elhep/SPEC_A7/PCB/SPEC-A7.PcbDoc.htm

Reporting Options

# File in Newer Format

Date | : | 25.06.2024
Time | : | 12:54:33
Filename | : | C:\temp\SPEC_A7-main\SPAC_A7\SPEC-A7.PcbDoc

Version | Warning
Release 23.6 | CAUTION - The PCB document contains Footprint parameters. These will be lost when opening the document in a version of Altium Designer that does not support this functionality.
Release 23.6 | CAUTION - The saved document contains custom masks for pads. These will be lost when opening the document in a version of Altium Designer that does not support this functionality

This file was generated by a later version of the software
