elhep/SPEC_A7/(list of files, drawings)

Other design files:
PCB/10M_PPS_OUT.SchDoc
PCB/Clocks_PLL.SchDoc
PCB/DIFF_DELAY_FANOUT.SchDoc
PCB/Ext_connectors.SchDoc
PCB/FPGA_14_15.SchDoc
PCB/FPGA_34.SchDoc
PCB/FPGA_MGT.SchDoc
PCB/FPGA_PWR_CONFIG.SchDoc
PCB/Misc.SchDoc
PCB/PCIe.SchDoc
PCB/Power.SchDoc
PCB/PPS_IN.SchDoc
PCB/SFP.SchDoc
PCB/SPEC-A7-TOP.SchDoc
PCB/SPEC_A7.PrjPcb
PCB/SPEC_A71/SamacSys.PcbLib
PCB/SPEC_A71/SPEC_A7.SCHLIB
PCB/TOD.SchDoc
PCB/USB_Serial_Quad.SchDoc
PCB/VCXO_25M_DDMTD.SchDoc
PCB/VCXO_25M_PTP.SchDoc
PCB/XO_125M.SchDoc
SPAC_A7/SPEC-A7.PcbDoc
