elhep/SPEC_A7/(threads)

Thread 1 (2024-02-20):

Low cost WR node - RFQ

gkasprow, 2024-02-20:
Initial specificacion:

Design based on Sinara EEM FMC Carrier
- FMC, memory, FPGA, stack up copied with the layout from EFC design
- Power supply copied from KASLI-DIOT
- 2 assembly variants: FMC or SMA/LEMO connectors: 2x IO, PPS OUT, 10MHZ OUT, programmable RF out
- on-board low jitter synthesizer like LMX2572 with SYNC controlled from WR core
- onboard GPS receiver or connectors for GPS signal: Rx/Tx, 10MHz IN, PPS IN
- PCIe x2
- SFP x1 or x2
- USB serial with JTAG programmer
- supplied from PCIe connector or external 12V barrel connector like in SPEC

kaolpr, 2024-02-20:
Some questions that comes to my mind:
- What are expected use-cases?
- Why go with different form-factor than Sinara/DIOT?
- How (despite the onboard GPS) this is different from SPEC7? Maybe we could just make a FMC with extra features? If CERN has step pricing for XC7Z035-1FBG676C the price tag may not be that lower after all.

gkasprow, 2024-02-20:
It's going to be ultra low cost minimalistic version of affordable WR node.
Same gateware and hw can be used for Wenzel DIOT module.

kaolpr, 2024-02-21:
So you basically want to mix https://ohwr.org/project/cute-wr-a7/wikis/home with https://ohwr.org/project/babywr/wikis/home and add GPS receiver?

I'm just curious if we could make it in a form-factor that would allow direct application in other projects (e.g. aforementioned Wenzel module) as a mezzanine or SOM?

gkasprow, 2024-02-21:
I want a single low-cost minimalistic WR node without using expensive SOCs, mezzanine connectors, and modules because they all add cost and make the total solution at least 2kEUR per piece.
I just found out the ARTIX-based WR-Cute version existed.
The idea is to make a module for stand-alone applications that can also be a reference for our Wenzel module.

gkasprow, 2024-03-07:
initial placement
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

gkasprow, 2024-06-05:
Initial routing
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

gkasprow, 2024-06-11:
Stand-alone version with management module
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

gkasprow, 2024-06-11:
Quad SPEC-A7 box
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

Thread 2 (2024-05-08):

SCH review

gkasprow, 2024-05-08:
- change designators of all ICs to IC, not U
- output of LMX2572RHA goes to SMA directly, not via TTL buffer
- all clock chips must be supplied via 3.3V LDO, make 3.6V output from DC/DC converter, pass it via LDO as in CUTE design
- use only CERN libraries
- add series termination at the OSC1 output going to LMX chip
- split PLL_CLK into dedicated clock pairs. for the moment it's hard see what signal goes where
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
- some outputs from AD9516 are LVPECL and need pulldowns + series resistors to match FPGA levels; look how it's made in WR switch design
- SFP_0.LED and SFP_1.LED goes to nowhere
- there are many errors in ERC, correct them all (but not by changing rules).
- use SPEC PCB with stackup as a template
- rename sheet FPGA34 to FPGA 34 SDRAM or add note SDRAM on schematic
- rename sheet FPGA PWR to FPGA PWR CONFIG
- use only CERN components; send me a list of missing ones
- make sure the oscillators are available. The ones used in CUTE-WR have the right PN in the part description.
- connect control lines of EXT pll in the same way as in CIRE-WR baseboard
-

gkasprow, 2024-05-18:
Add I2C 24c64 eeprom connected in the same way as on SPEC

gkasprow, 2024-05-21:
- [ ] we need SDRAM, we have free 15 pins in bank 15 so no need to sacrify the SDRAM
- [ ] we don't need all the LMX control pins, just SPI and SYNC

gkasprow, 2024-05-21:
- [ ] please add note on schematic about bank power supply value

gkasprow, 2024-05-21:
- [ ] use NP0 for C139, C150, we need them to be low noise caps
- [ ] pls use MGT0, 1 for PCIe, MGT2,3 for SFP or vice-versa, don't interleave them
- [ ] we do need PCIe clock, move 125MHz clock to bank 15 clock input and add capacitor assembly option to route CLK125 to either bank 15 or MGT bank
- [ ] add 24LC64 EEPROM connected to I2C lines
- [ ] add assembly option (2x 0R resistors) that bypasses IC22, IC20, IC23 (low cost version)

gkasprow, 2024-05-21:
- [ ] add annotation about levels of RGMII and other non 3V3 signals on ext connector

gkasprow, 2024-05-21:
- [ ] missing TOD IN, TOD OUT; make it as MMCX
- [ ] replace HSMS diodes by popular BAV** Schottky ones
- [ ] can we unify 3.3V LDOs? Use low cost ones, preferably from DIODES/Microchip/Onsemi
- [ ] V_tap is current measurement; add low cost current measurement chip
- [ ] replace oscilaltors PN
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

gkasprow, 2024-05-21:
- [ ] wrong variant may cause board damage: use no_value components
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

gkasprow, 2024-05-21:
- [ ] add separate i2C connectors for dc/dc converters, they all share same I2C address
- [ ] is JTAG 2.5V or 3.3V?
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

gkasprow, 2024-05-21:
- [ ] move RGMII to 3.3V bank to match levels of IMX93/STM32 CPU

gkasprow, 2024-05-28:
- [ ] add series termination resistors (33Ohm or so) to RGMII Tx pins (FPGA outputs)

gkasprow, 2024-06-05:
- [ ] add HyperRAM

gkasprow, 2024-06-06:
- [ ] remove T2, reduce R31 to 3k3 and supply LD2 from P5V0 directly; for the moment LD2 threshold is below 1V.
- [ ] replace LT1965EDD#PBF (IC41, IC17, IC18) with cheaper LDO like
- [ ] use CERN libraries, replace BLM18KG221SN1D with BLM18SG221TN1 everywhere
- [ ] ADR1500BKSZ is not available, replace it with LM1041 or sth cheap having 1.25V
- [ ] We don't need U1A x 4 to drive the FPGA input. Use one I1A buffer as TOD IN and 3 U1A buffers as TOD OUT, there is no need to use IC39 and 5V0 rail
- [ ] I think we could reduce the number of DC/DC converters. We don't need 5V rail, VCCBRAM could be connected with MGTAVCC. We don't need 6A at P1V0 rail as well as 6A at MGTAVCC rail. MPM54304GMN-0001 has 4 independent output channels.

gkasprow, 2024-06-06:
- [ ] please add 0805 1mOhm resistors at each DC/DC output, we will measure the currents and decide how to simplify the rails in next revision

gkasprow, 2024-06-07:
- [ ] use WUT templates for all schematic files

gkasprow, 2024-06-11:
- [ ] pls add power LED  on the front panel and one LED under each SMA connector

gkasprow, 2024-06-25:
- [ ] add OSC_CONNOR-WINFIELD_DOT050V as alternative VCXO
- [ ] add FT230XS-R as alternative low cost UART

gkasprow, 2024-06-25:
- [ ] swap R25 with R27
- [ ] swap R13 with R14

mkiepiela, 2024-07-01:
- [ ] Connect nREFIN of IC14 to GND (via capacitor).
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

- [ ] C242 and C243 should be 100 nF.
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

- [ ] IC39, IC44 and IC45 are powered by 5V0 while ICLK are driven by 3V3 level signals. Minimum input H level is higher than the signal.
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

- [ ] Output impedance of IC39, IC44 and IC45 is about 20R, so R154, R190 and R195 should be about 30R (not 47R) or even less if R155, R193 or R198 are mounted. Place a note on the scheme.
- [ ] EN pin of IC3 is driven by MGTAVTT (1V2). It's to less - EN threshold is 1.21V +/- 2.5%.
- [ ] I2C 10k pull ups (R40, R41) - should be 2k2 if 400 kHz mode is to be used.
- [ ] Lack of 100 nF caps at P1V8_USB pins of IC32.
- [ ] R113/R114 divider - change values to not exceed nRESET input level of IC32. Increase R113 due to application note:
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

- [ ] Schematic symbol of Y2 does not correspond to its PN. Pin 2 should be OE not nST.

gkasprow, 2024-07-22:
C139, C150 PN indicates 10nF

Thread 7 (2024-10-08):

move JTAG connector

gkasprow, 2024-10-08:
It collides with Eurocard rack

Thread 10 (2025-04-15):

P3V0_VCXO oscillation

polprog, 2025-04-15:
When using MIC5129 (IC47) to power the VCXO, its output rail has some heavy oscillations (400mVpp, 9kHz ). This results in bad phase noise performance on the 25MHz clock and in turn 10MHz output.

It is caused by not enough capacitance on the LDO output. A temporary fix was carried out on one of the boards by attaching 22uF 10V tantalum cap (Vishay 293D226X9010A2TE3) instead of C161 and connecting the ground with soldering braid for low Z path.

MIC5129 datasheet states that:

An output capacitor is required between OUT and GND
to prevent oscillation. The minimum size of the output
capacitor is dependent upon whether a reference
bypass capacitor is used. 1 μF minimum is
recommended when C BYP is not used (see Figure 4-5).
2.2 μF minimum is recommended when C BYP is 470 pF
(see Figure 4-6). **For applications <3V, the output
capacitor should be increased to 22 μF minimum to
reduce start-up overshoot.** Larger values improve the
regulator’s transient response. The output capacitor
value may be increased without limit.

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

gkasprow, 2025-04-15:
This is not an issue with too low capacitance but with  capacitor losses. Just replace ceramic one with tantalum one.

polprog, 2025-05-12:
The output capacitors on IC19, IC46, IC47 were replaced with 10uF 16V tantalum capacitors, this fixes the LDO oscillations.

Thread 11 (2025-05-12):

Spurs on 10MHz output

polprog, 2025-05-12:
The output buffers IC44 and IC45 are powered directly from a buck converter which leads to mixing of power supply ripple with frequency outputs. This creates a spur in phase noise at the operating frequency of the buck.

Fix:

IC44 power supply should be modified. FB30 should be replaced with a 1uH inductor with enough ampacity, and a 47uF ceramic capacitor should be added across VCC and GND pins of the IC. IC45 circuit should be modified in the same way.

Thread 12 (2025-06-12):

Compliance with PCI Express Card Electromechanical Specification

gravelpitman, 2025-06-12:
Hi, I would like to propose a change to the PCB design to make it more compliant with the PCI Express® Card Electromechanical Specification (https://cdck-file-uploads-global.s3.dualstack.us-west-2.amazonaws.com/nvidia/original/3X/2/0/20a75bdbb6bc42db8b2cb0b7c77f3e492a274508.pdf)

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

Proposed changes:

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

-   In my opinion, the front edge of the PCB should be extended, and the rear edge shortened to maintain the overall PCB length. The total length should ideally be slightly less than 160 mm to ensure proper fit and assemblability.

-   The SFP cage has been moved downward to avoid interference with the standard PCIe bracket.

-  The SMA connectors have been slightly repositioned (squeezed) to fit the required layout constraints.

- The LEDs are positioned to allow the use of LED light pipes from the Bivar PLPC1-100 series ([link](https://www.tme.eu/pl/details/plpc1-100/swiatlowody-do-led/bivar/)), and are aligned with the SMA connectors and other front panel components.

I haven’t considered the Spec_A7_Management PCB at this stage. If it's required, I can incorporate it.

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

Please also note that the PCIe connector opening in the bracket may obstruct some features on the front panel (e.g. one of the LEDs may be partially blocked).
