elhep/SPEC_A7/(commit log)

2024-05-09 fixed some issues
    [Clocks_PLL.SchDoc, DIFF_DELAY_FANOUT.SchDoc, Ext_connectors.SchDoc, FPGA_14_15.SchDoc, FPGA_34.SchDoc, FPGA_MGT.SchDoc, FPGA_PWR.SchDoc, FPGA_PWR_CONFIG.SchDoc]
2024-05-17 initial placement
    [Clocks_PLL.SchDoc, Power.SchDoc, SFP.SchDoc, SPEC-A7-TOP.SchDoc, SPEC_A7.PrjPcb]
2024-05-31 routing done
    [Clocks_PLL.SchDoc, DIFF_DELAY_FANOUT.SchDoc, Ext_connectors.SchDoc, FPGA_14_15.SchDoc, FPGA_34.SchDoc, FPGA_MGT.SchDoc, FPGA_PWR_CONFIG.SchDoc, Misc.SchDoc]
2024-06-10 fixed issues
    [10M_PPS_OUT.SchDoc, Clocks_PLL.SchDoc, DIFF_DELAY_FANOUT.SchDoc, Ext_connectors.SchDoc, FPGA_14_15.SchDoc, FPGA_34.SchDoc, FPGA_PWR_CONFIG.SchDoc, Misc.SchDoc]
2024-06-12 added FP Leds
    [FPGA_14_15.SchDoc, Misc.SchDoc, TOD.SchDoc]
2024-06-15 removed double PPS/10M out
    [10M_PPS_OUT.SchDoc, Clocks_PLL.SchDoc, DIFF_DELAY_FANOUT.SchDoc, Ext_connectors.SchDoc, FPGA_34.SchDoc, PPS_IN.SchDoc, SPEC-A7-TOP.SchDoc, SPEC_A7.PrjPcb]
2024-06-23 minore changes
    [Power.SchDoc, TOD.SchDoc]
2024-07-02 fixes after review
    [Clocks_PLL.SchDoc, DIFF_DELAY_FANOUT.SchDoc, Ext_connectors.SchDoc, FPGA_34.SchDoc, Power.SchDoc, TOD.SchDoc, USB_Serial_Quad.SchDoc, VCXO_25M_DDMTD.SchDoc]
2024-07-03 fixed wrong oscillator placement and PCIe clock routing; added template for schematics
    [Clocks_PLL.SchDoc, DIFF_DELAY_FANOUT.SchDoc, Ext_connectors.SchDoc, FPGA_14_15.SchDoc, FPGA_34.SchDoc, FPGA_MGT.SchDoc, FPGA_PWR_CONFIG.SchDoc, Misc.SchDoc]
2024-07-04 rev1.0 rc1
    [10M_PPS_OUT.SchDoc, Clocks_PLL.SchDoc, DIFF_DELAY_FANOUT.SchDoc, Ext_connectors.SchDoc, FPGA_14_15.SchDoc, FPGA_34.SchDoc, FPGA_MGT.SchDoc, FPGA_PWR_CONFIG.SchDoc]
